Malevolti/Lyra/case files/alps-matias-plate.stl

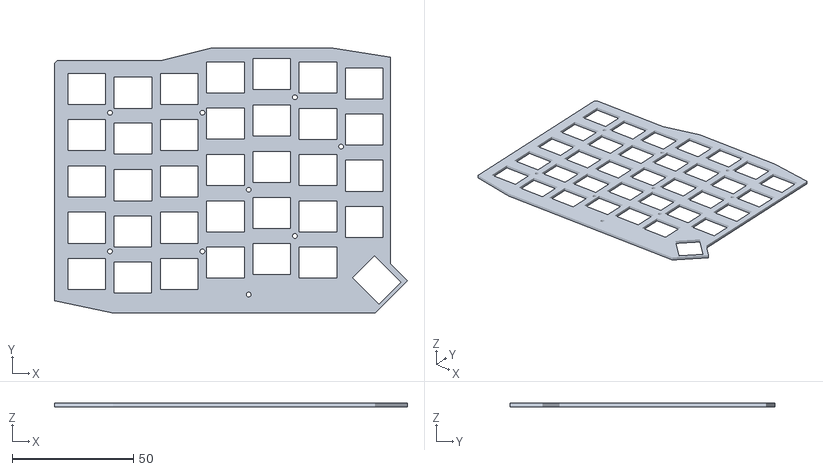
[picture p1: CAD file, 2021-08-31]
case files/alps-matias-plate.stl
145.5 x 109.2 x 1.50
