Malevolti/Lyra/case files/ultra-low-profile-case.stl

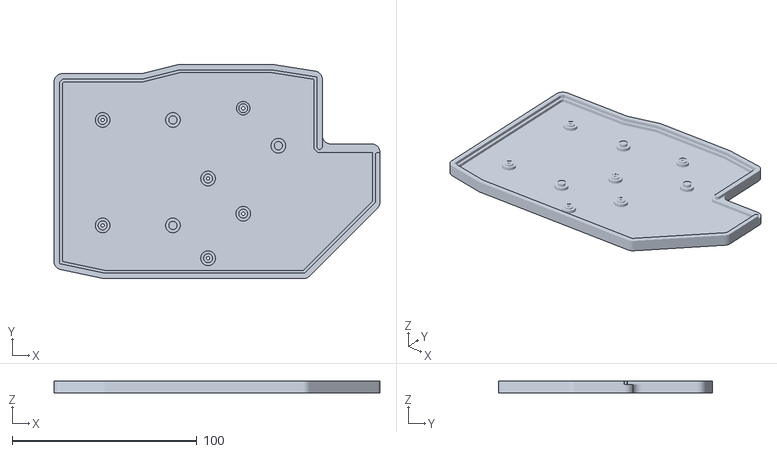
[picture p2: CAD file, 2021-08-30]
case files/ultra-low-profile-case.stl
176.7 x 116.2 x 6.50
