Malevolti/Lyra/case files/ulp-mount-luggs.stl

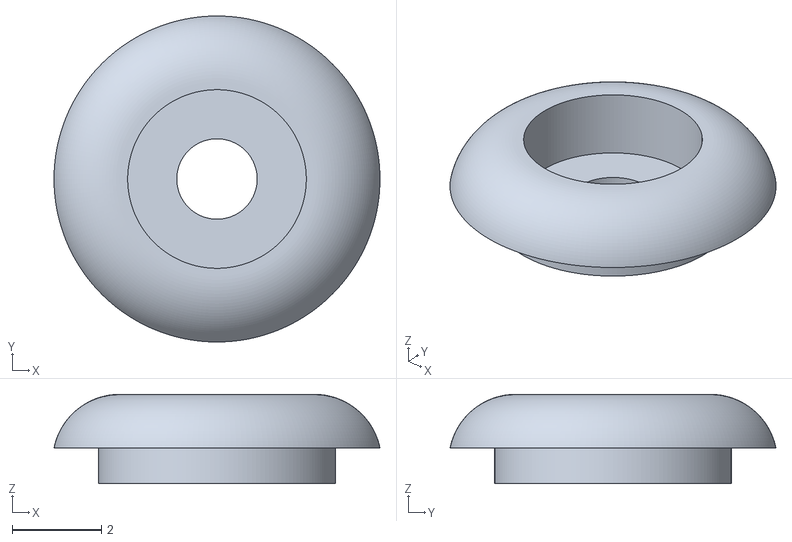
[picture p3: CAD file, 2021-08-30]
case files/ulp-mount-luggs.stl
7.30 x 7.30 x 2.00
