Malevolti/Lyra/case files/mid-profile-case.stl

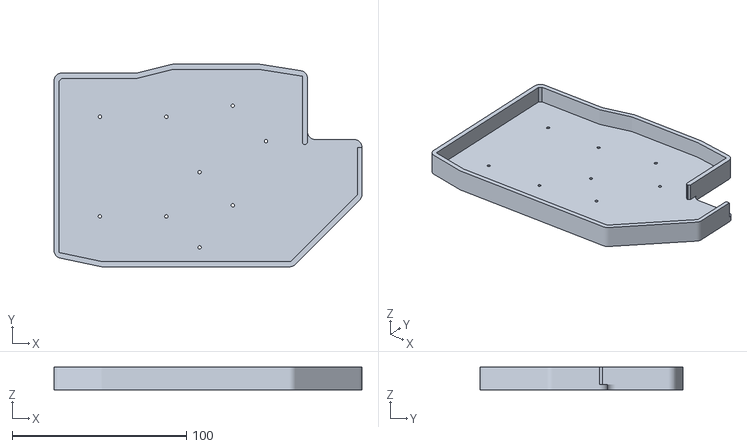
[picture p4: CAD file, 2021-08-30]
case files/mid-profile-case.stl
176.7 x 116.2 x 13.0
