Malevolti/Lyra/(list of files, cad)

Other CAD files:
case files/mx-choc-plate.stl
