Malevolti/Lyra/pcb/Lyra-HS.kicad_pcb

## KiCad design pcb/Lyra-HS.kicad_pcb (2022-01-26)

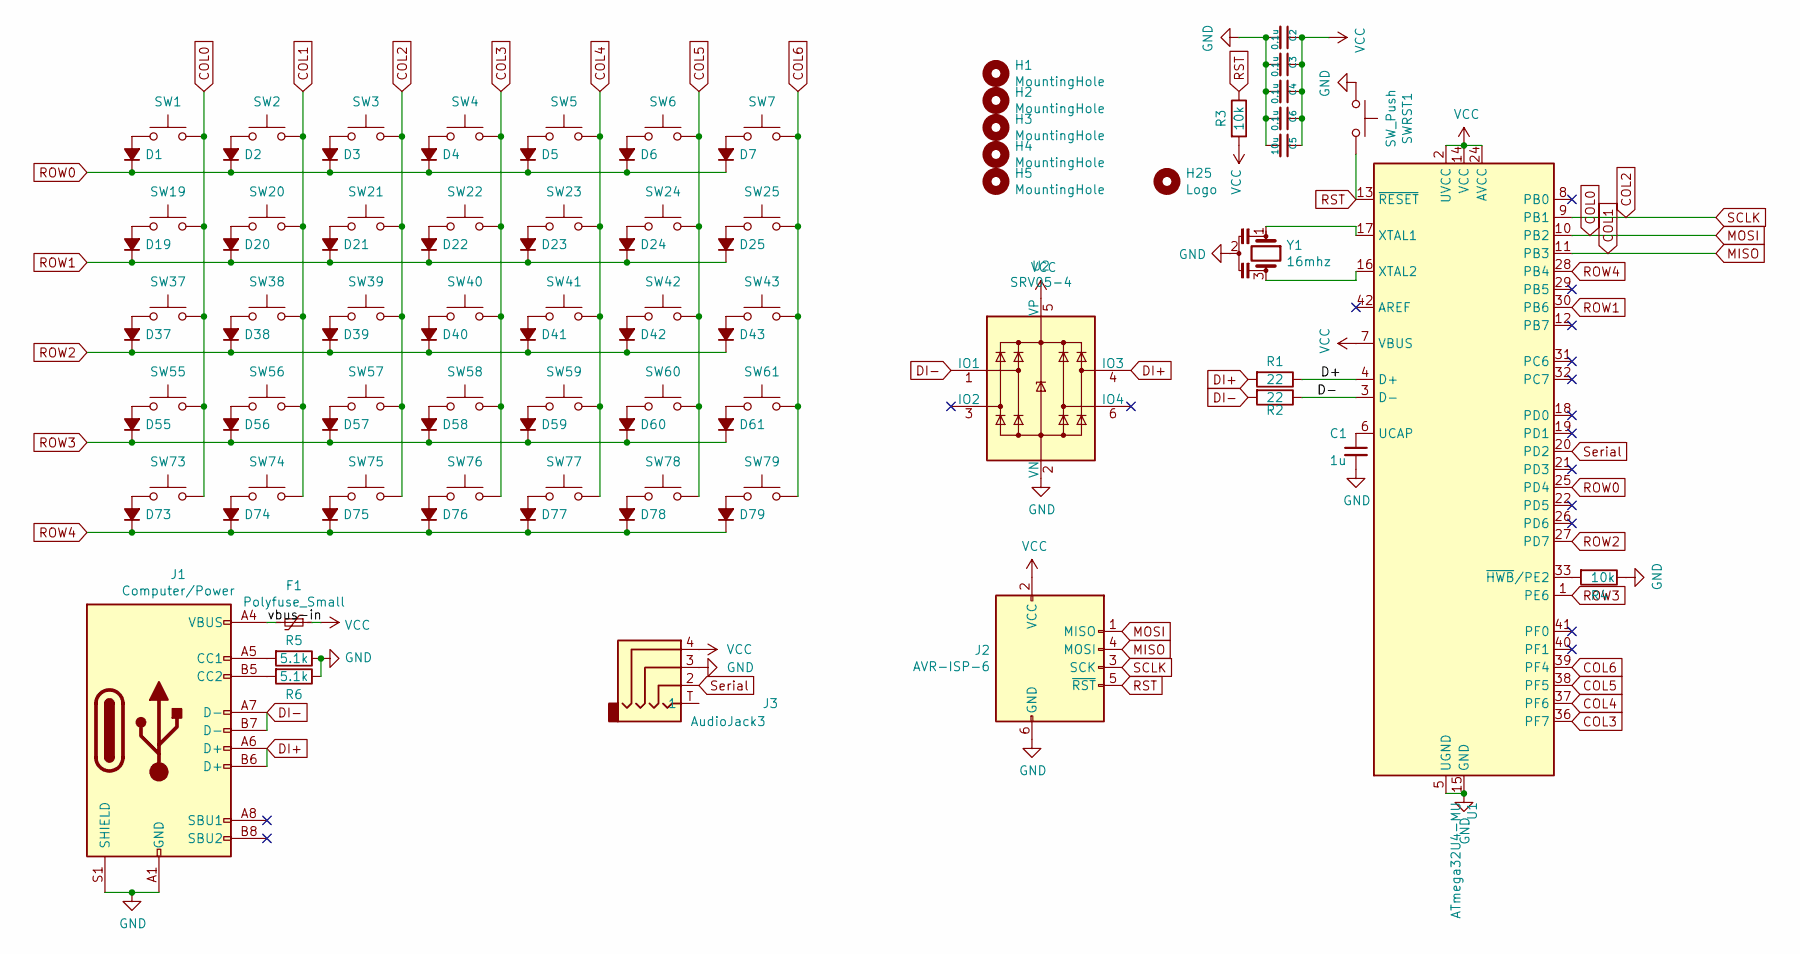
[picture p5: schematic Lyra-HS.kicad_sch, Lyra]

Parts:
C1: 1u; C_0402; LCSC C106253
C2, C3, C4, C6: 0.1u; C_0402; LCSC C106204
C5: 10u; C_0402; LCSC C237279
D1, D2, D3, D4, D5, D6, D7, D19, D20, D21, D22, D23, D24, D25, D37, D38, D39, D40, D41, D42, D43, D55, D56, D57, D58, D59, D60, D61, D73, D74, D75, D76, D77, D78, D79: D_Small_ALT; D_SOD-123F; LCSC C2099
F1: Polyfuse_Small; Fuse_0402_1005Metric; LCSC C914085
H1, H2, H3, H4, H5: MountingHole; MountingHole_2.2mm_M2_ISO7380_Pad
H25: Logo; SuperLyraLogo
J1: Computer/Power; USB_C_Receptacle_HRO_TYPE-C-31-M-12; LCSC C165948
J2: AVR-ISP-6; PinSocket_2x03_P2.54mm_Vertical
J3: AudioJack3; TRRS-PJ-320A-Dual-Overlayed
R1, R2: 22; R_0402_1005Metric_Pad0.72x0.64mm_HandSolder; LCSC C93929
R3, R4: 10k; R_0402_1005Metric_Pad0.72x0.64mm_HandSolder; LCSC C60489
R5, R6: 5.1k; R_0402_1005Metric_Pad0.72x0.64mm_HandSolder; LCSC C25905
SW1, SW2, SW3, SW4, SW5, SW6, SW7, SW19, SW20, SW21, SW22, SW23, SW24, SW25, SW37, SW38, SW39, SW40, SW41, SW42, SW43, SW55, SW56, SW57, SW58, SW59, SW60, SW61, SW73, SW74, SW75, SW76, SW77, SW78, SW79: SW_Push; MX_Choc_Hotswap
SWRST1: SW_Push; SW_SPST_TL3342; LCSC C318884
U1: ATmega32U4-MU; QFN-44-1EP_7x7mm_P0.5mm_EP5.2x5.2mm; LCSC C112161
U2: SRV05-4; SOT-23-6; LCSC C558418
Y1: 16mhz; Resonator_SMD_Murata_CSTxExxV-3Pin_3.0x1.1mm; LCSC C341521

Connections:
/D+: R1.1, U1.4 (D+)
/D-: R2.1, U1.3 (D-)
/vbus-in: F1.2, J1.A4 (VBUS), J1.A9 (VBUS), J1.B4 (VBUS), J1.B9 (VBUS)
COL0: J2.1 (MISO), SW1.2, SW19.2, SW37.2, SW55.2, SW73.2, U1.10 (PB2)
COL1: J2.4 (MOSI), SW2.2, SW20.2, SW38.2, SW56.2, SW74.2, U1.11 (PB3)
COL2: J2.3 (SCK), SW3.2, SW21.2, SW39.2, SW57.2, SW75.2, U1.9 (PB1)
COL3: SW4.2, SW22.2, SW40.2, SW58.2, SW76.2, U1.36 (PF7)
COL4: SW5.2, SW23.2, SW41.2, SW59.2, SW77.2, U1.37 (PF6)
COL5: SW6.2, SW24.2, SW42.2, SW60.2, SW78.2, U1.38 (PF5)
COL6: SW7.2, SW25.2, SW43.2, SW61.2, SW79.2, U1.39 (PF4)
DI+: J1.A6 (D+), J1.B6 (D+), R1.2, U2.4 (IO3)
DI-: J1.A7 (D-), J1.B7 (D-), R2.2, U2.1 (IO1)
GND: C1.2, C2.2, C3.2, C4.2, C5.2, C6.2, J1.A1 (GND), J1.A12 (GND), J1.B1 (GND), J1.B12 (GND), J1.S1 (SHIELD), J2.6 (GND), J3.3, R4.1, R5.1, R6.1, SWRST1.1, U1.5 (UGND), U1.15 (GND), U1.23 (GND), U1.35 (GND), U1.43 (GND), U1.45 (GND), U2.2 (VN), Y1.2
unnamed: C1.1, U1.6 (UCAP)
unnamed: D1.2 (A), SW1.1
unnamed: D2.2 (A), SW2.1
unnamed: D3.2 (A), SW3.1
unnamed: D4.2 (A), SW4.1
unnamed: D5.2 (A), SW5.1
unnamed: D6.2 (A), SW6.1
unnamed: D7.2 (A), SW7.1
unnamed: D19.2 (A), SW19.1
unnamed: D20.2 (A), SW20.1
unnamed: D21.2 (A), SW21.1
unnamed: D22.2 (A), SW22.1
unnamed: D23.2 (A), SW23.1
unnamed: D24.2 (A), SW24.1
unnamed: D25.2 (A), SW25.1
unnamed: D37.2 (A), SW37.1
unnamed: D38.2 (A), SW38.1
unnamed: D39.2 (A), SW39.1
unnamed: D40.2 (A), SW40.1
unnamed: D41.2 (A), SW41.1
unnamed: D42.2 (A), SW42.1
unnamed: D43.2 (A), SW43.1
unnamed: D55.2 (A), SW55.1
unnamed: D56.2 (A), SW56.1
unnamed: D57.2 (A), SW57.1
unnamed: D58.2 (A), SW58.1
unnamed: D59.2 (A), SW59.1
unnamed: D60.2 (A), SW60.1
unnamed: D61.2 (A), SW61.1
unnamed: D73.2 (A), SW73.1
unnamed: D74.2 (A), SW74.1
unnamed: D75.2 (A), SW75.1
unnamed: D76.2 (A), SW76.1
unnamed: D77.2 (A), SW77.1
unnamed: D78.2 (A), SW78.1
unnamed: D79.2 (A), SW79.1
unnamed: J1.A5 (CC1), R5.2
unnamed: J1.B5 (CC2), R6.2
unnamed: R4.2, U1.33 (~HWB/PE2)
unnamed: U1.16 (XTAL2), Y1.3
unnamed: U1.17 (XTAL1), Y1.1
ROW0: D1.1 (K), D2.1 (K), D3.1 (K), D4.1 (K), D5.1 (K), D6.1 (K), D7.1 (K), U1.25 (PD4)
ROW1: D19.1 (K), D20.1 (K), D21.1 (K), D22.1 (K), D23.1 (K), D24.1 (K), D25.1 (K), U1.30 (PB6)
ROW2: D37.1 (K), D38.1 (K), D39.1 (K), D40.1 (K), D41.1 (K), D42.1 (K), D43.1 (K), U1.27 (PD7)
ROW3: D55.1 (K), D56.1 (K), D57.1 (K), D58.1 (K), D59.1 (K), D60.1 (K), D61.1 (K), U1.1 (PE6)
ROW4: D73.1 (K), D74.1 (K), D75.1 (K), D76.1 (K), D77.1 (K), D78.1 (K), D79.1 (K), U1.28 (PB4)
RST: J2.5 (~RST), R3.1, SWRST1.2, U1.13 (~RESET)
Serial: J3.2, U1.20 (PD2)
VCC: C2.1, C3.1, C4.1, C5.1, C6.1, F1.1, J2.2 (VCC), J3.4, R3.2, U1.2 (UVCC), U1.7 (VBUS), U1.14 (VCC), U1.24 (AVCC), U1.34 (VCC), U1.44 (AVCC), U2.5 (VP)

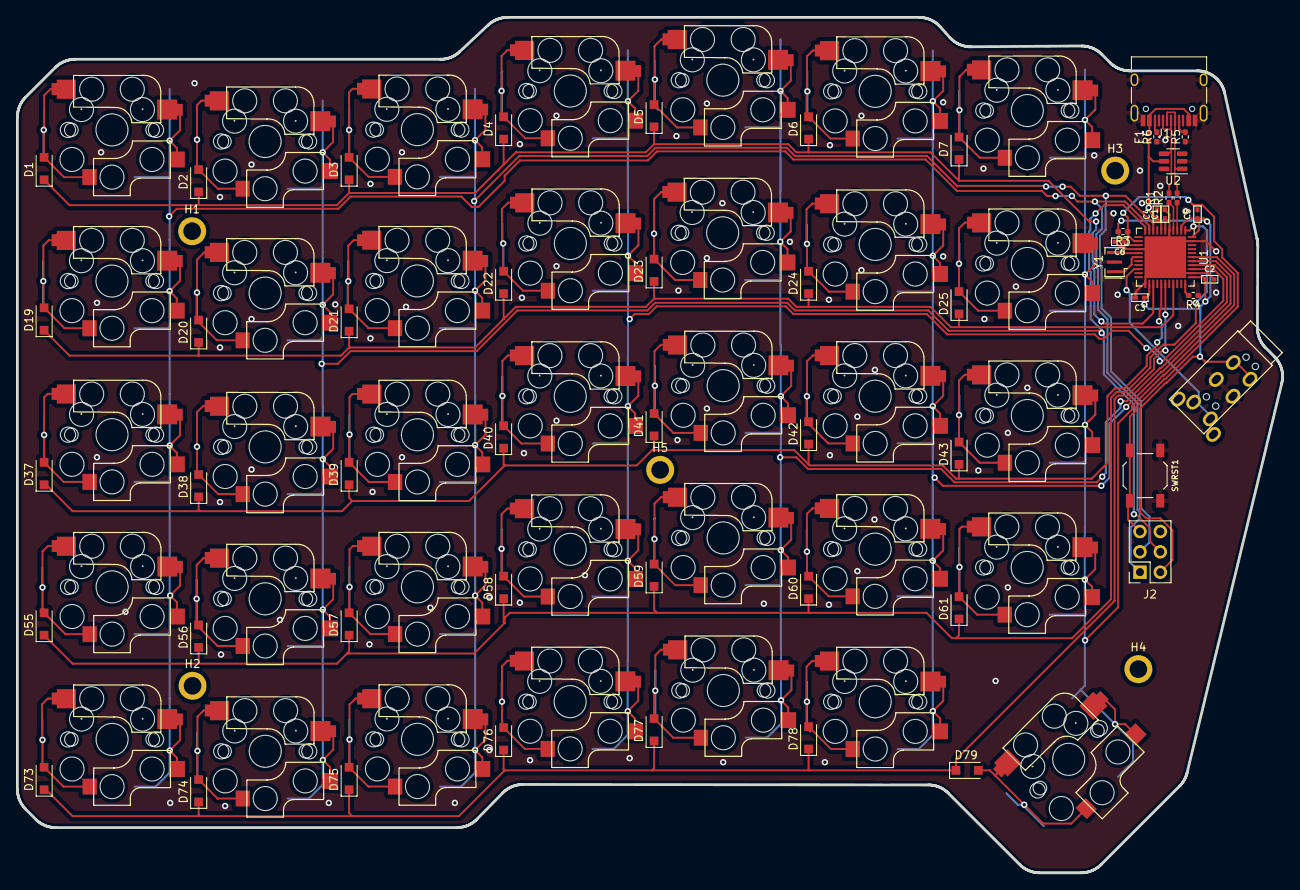
[picture p6: board Lyra-HS.kicad_pcb from above]

Board: 2 copper layers, 158.1 x 106.9 mm, 95 parts (0 on the bottom side), 62 nets.
