Malevolti/Lyra/pcb/legacy/lyraLeft.kicad_pcb

## KiCad design pcb/legacy/lyraLeft.kicad_pcb (2022-01-23, an earlier design)

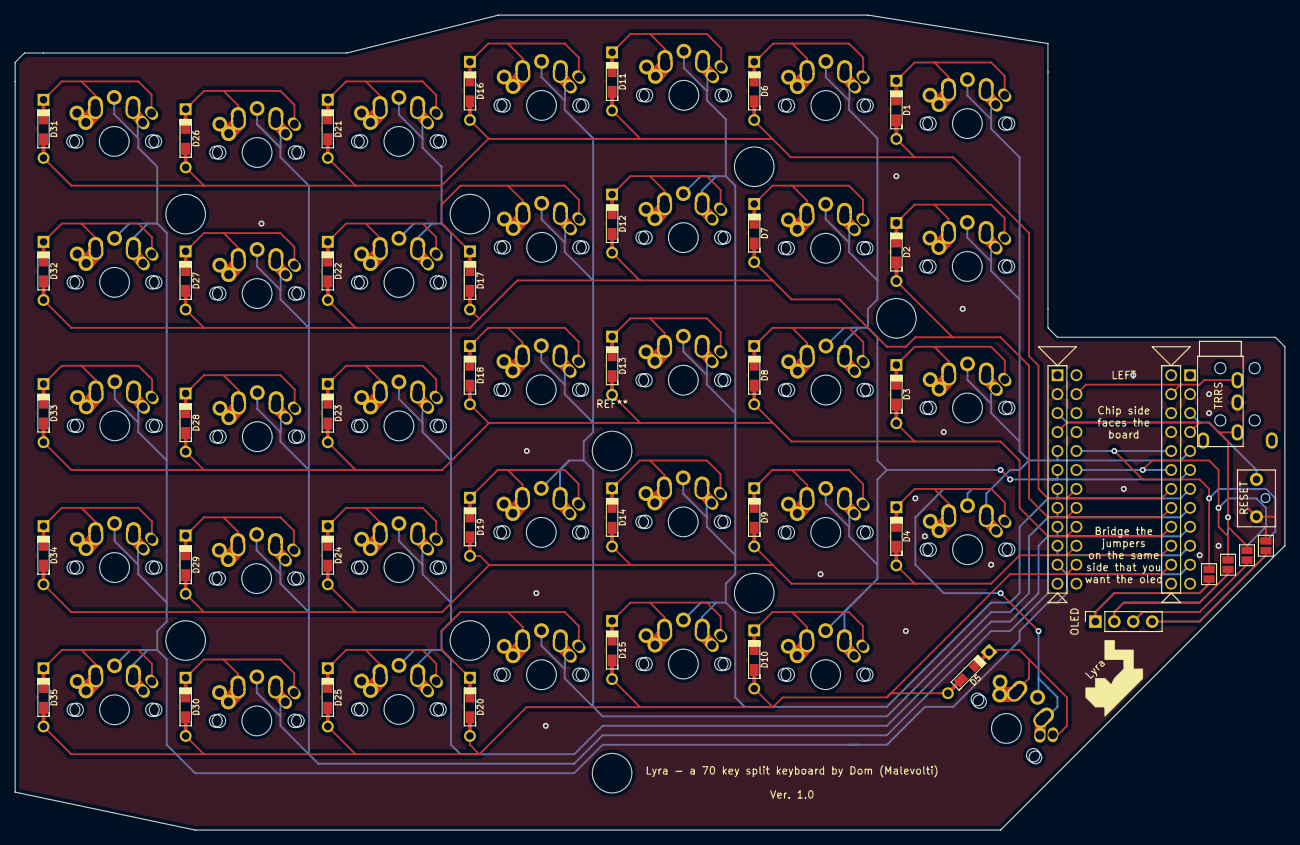
[picture p7: board lyraLeft.kicad_pcb from above]

Board: 2 copper layers, 170.2 x 109.2 mm, 73 parts (0 on the bottom side), 55 nets.

Parts:
D1, D2, D3, D4, D5, D6, D7, D8, D9, D10, D11, D12, D13, D14, D15, D16, D17, D18, D19, D20, D21, D22, D23, D24, D25, D26, D27, D28, D29, D30, D31, D32, D33, D34, D35: DIODE; Diode-dual
OLED: PinSocket_1x04_P2.54mm_Vertical
RESET: SW_PUSH; SW_Tactile_SPST_Angled_MJTP1117-no-mount
SW1: SW_SPST; Triple-Dual-1u-NOLED
SW2, SW3, SW4, SW5, SW6, SW7, SW8, SW9, SW10, SW11, SW12, SW13, SW14, SW15, SW16, SW17, SW18, SW19, SW20, SW21, SW22, SW23, SW24, SW25, SW26, SW27, SW28, SW29, SW30, SW31, SW32, SW33, SW34, SW35: SW_SPST; Triple-Dual-1u-LED
U1: ATmega32U4-MU; ProMicro

Connections:
Earth: RESET.2, U1.2, U1.21, U1.22
unnamed: D1.1, SW1.1
unnamed: D1.2, D6.2, D11.2, D16.2, D21.2, D26.2, D31.2
unnamed: D2.1, SW2.1
unnamed: D3.1, SW3.1
unnamed: D4.1, SW4.1
unnamed: D5.1, SW5.1
unnamed: D6.1, SW6.1
unnamed: D7.1, SW7.1
unnamed: D8.1, SW8.1
unnamed: D9.1, SW9.1
unnamed: D10.1, SW10.1
unnamed: D5.2, D10.2, D15.2, D20.2, D25.2, D30.2, D35.2
unnamed: D11.1, SW11.1
unnamed: D12.1, SW12.1
unnamed: D2.2, D7.2, D12.2, D17.2, D22.2, D27.2, D32.2
unnamed: D13.1, SW13.1
unnamed: D3.2, D8.2, D13.2, D18.2, D23.2, D28.2, D33.2
unnamed: D14.1, SW14.1
unnamed: D4.2, D9.2, D14.2, D19.2, D24.2, D29.2, D34.2
unnamed: D15.1, SW15.1
unnamed: D16.1, SW16.1
unnamed: D17.1, SW17.1
unnamed: D18.1, SW18.1
unnamed: D19.1, SW19.1
unnamed: D20.1, SW20.1
unnamed: D21.1, SW21.1
unnamed: D22.1, SW22.1
unnamed: D23.1, SW23.1
unnamed: D24.1, SW24.1
unnamed: D25.1, SW25.1
unnamed: D26.1, SW26.1
unnamed: D27.1, SW27.1
unnamed: D28.1, SW28.1
unnamed: D29.1, SW29.1
unnamed: D30.1, SW30.1
unnamed: D31.1, SW31.1
unnamed: D32.1, SW32.1
unnamed: D33.1, SW33.1
unnamed: D34.1, SW34.1
unnamed: D35.1, SW35.1
unnamed: RESET.1, U1.3
unnamed: SW1.2, SW2.2, SW3.2, SW4.2, SW5.2
unnamed: SW6.2, SW7.2, SW8.2, SW9.2, SW10.2
unnamed: SW11.2, SW12.2, SW13.2, SW14.2, SW15.2
unnamed: SW16.2, SW17.2, SW18.2, SW19.2, SW20.2
unnamed: SW21.2, SW22.2, SW23.2, SW24.2, SW25.2
unnamed: SW26.2, SW27.2, SW28.2, SW29.2, SW30.2, U1.11
unnamed: SW31.2, SW32.2, SW33.2, SW34.2, SW35.2, U1.10
unnamed: U1.23, U1.24
unnamed: U1.5, U1.17
unnamed: U1.6, U1.16
unnamed: U1.7, U1.15
unnamed: U1.8, U1.14
unnamed: U1.9, U1.13
