Malevolti/Lyra/(commit log)

2021-08-12 add pcb
    [LCase.stl, LPlate.stl, RCase.stl, RPlate.stl, lyraLeft.kicad_pcb]
2021-08-30 add case files
    [mid-profile-case.stl, mx-choc-plate.stl, ulp-mount-luggs.stl, ultra-low-profile-case.stl]
2021-08-30 update ULP case
    Better pcb support, some mount points made passive due to no clearance between switch & lug
    [ultra-low-profile-case.stl]
2022-01-23 Initial 'R2G' schem
    [Lyra-HS.kicad_sch, Lyra-HS.sch, lyraLeft.kicad_pcb]
2022-01-23 Initial PCB
    (Super alpha, basically no traces)
2022-01-24 Initial matrix layout
    [Lyra-HS.kicad_pcb, Lyra-HS.kicad_sch]
2022-01-24 Initial MCU>Matrix hookup
    [Lyra-HS.kicad_pcb]
2022-01-24 Initial Edge Cuts
    [Lyra-HS.kicad_pcb]
2022-01-25 MCU area shenanigans
    [Lyra-HS.kicad_pcb]
2022-01-26 Matrix impedance optimisations
    +change to desolder-friendly trrs jack footprint
    [Lyra-HS.kicad_pcb, Lyra-HS.kicad_sch]
2022-01-26 edge cut changes
    empty space removed below MCU/TRRS
2022-01-28 Changed USB-C port from Top-mount to Mid-mount
    [Lyra-HS.kicad_sch]
